silaswaxter/senior_design_buck_converter/requirements.md

# Requirements for Buck Converter

- Needs to be implemented via a custom PCB you designed
- Vin can be 8V-15V. Vout must be 5V nominal (±300mV) at 1.5A Inominal
- Main chip is TPS54232D/TPS54233D (start from figure 10, read about recommended
  layout in section 11.2)
  - We have a small supply of these chips if you can not find one
