silaswaxter/senior_design_buck_converter/recitation_buck_converter.kicad_pcb

## KiCad design recitation_buck_converter.kicad_pcb (2023-11-02)

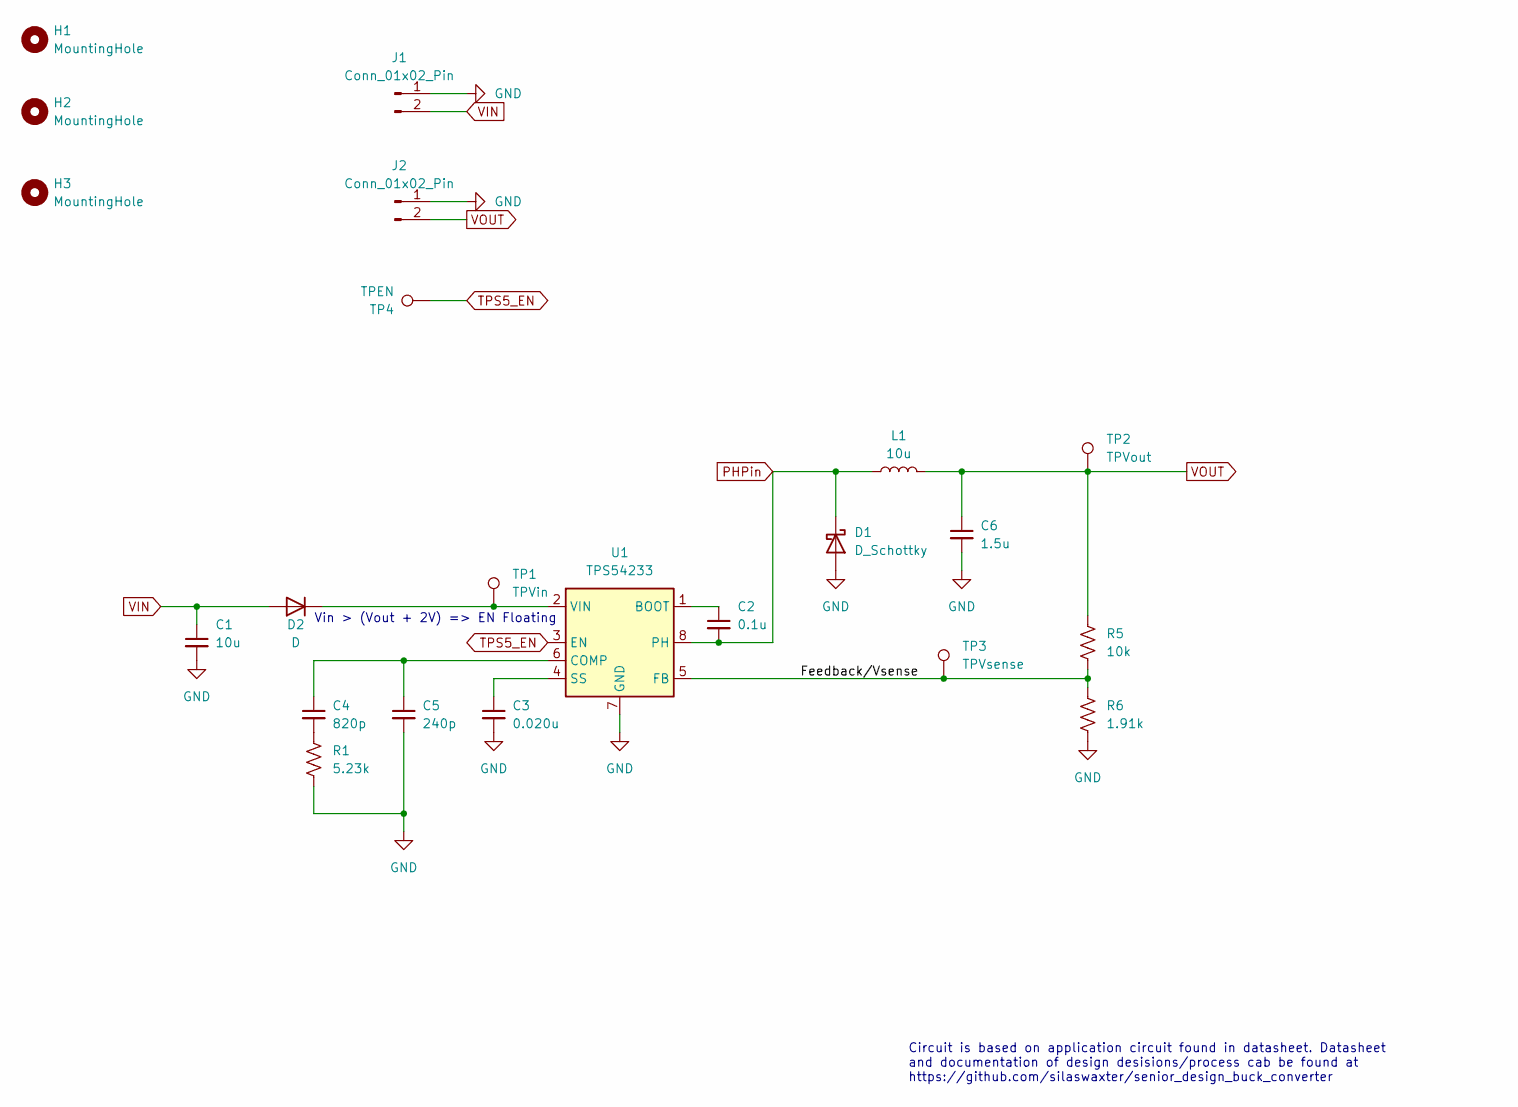
[picture p1: schematic recitation_buck_converter.kicad_sch, Buck Converter Sample]

Parts:
C1: 10u; C_0805_2012Metric_Pad1.18x1.45mm_HandSolder; Digikey PN 399-11939-2-ND
C2: 0.1u; C_0805_2012Metric_Pad1.18x1.45mm_HandSolder; Digikey PN 399-C0805C104M5RAC7800CT-ND
C3: 0.020u; C_0805_2012Metric_Pad1.18x1.45mm_HandSolder; Digikey PN 478-08055C203KAT2ATR-ND
C4: 820p; C_0805_2012Metric_Pad1.18x1.45mm_HandSolder; Digikey PN 311-3382-1-ND
C5: 240p; C_0805_2012Metric_Pad1.18x1.45mm_HandSolder; Digikey PN 311-4232-1-ND
C6: 1.5u; C_0805_2012Metric_Pad1.18x1.45mm_HandSolder; Digikey PN 732-7655-2-ND
D1: D_Schottky; US2H; Digikey PN CUHS20F30H3FTR-ND
D2: D; D_SMA; Digikey PN 2616-SK26A-ND
H1, H2, H3: MountingHole; MountingHole_2.2mm_M2; Digikey PN DNP
J1, J2: Conn_01x02_Pin; JST_XH_B2B-XH-AM_1x02_P2.50mm_Vertical; Digikey PN DNP
L1: 10u; L_Axial_L9.5mm_D4.0mm_P5.08mm_Vertical_Fastron_SMCC; Digikey PN 495-6962-1-ND
R1: 5.23k; R_0805_2012Metric_Pad1.20x1.40mm_HandSolder; Digikey PN 311-5.23KCRCT-ND
R5: 10k; R_0805_2012Metric; Digikey PN RMCF0805FT10K0TR-ND
R6: 1.91k; R_0805_2012Metric_Pad1.20x1.40mm_HandSolder; Digikey PN 311-1.91KCRTR-ND
TP1: TPVin; TestPoint_Pad_1.5x1.5mm
TP2: TPVout; TestPoint_Pad_1.5x1.5mm
TP3: TPVsense; TestPoint_Pad_1.5x1.5mm
TP4: TPEN; TestPoint_Pad_1.5x1.5mm
U1: TPS54233; SOIC-8_3.9x4.9mm_P1.27mm; Digikey PN 296-23902-1-ND

Connections:
/Feedback/Vsense: R5.2, R6.1, TP3.1, U1.5 (FB)
GND: C1.2, C3.2, C5.2, C6.2, D1.2 (A), J1.1, J2.1, R1.2, R6.2, U1.7 (GND)
unnamed: C4.2, R1.1
unnamed: D2.1 (K), TP1.1, U1.2 (VIN)
unnamed: C2.1, U1.1 (BOOT)
unnamed: C4.1, C5.1, U1.6 (COMP)
unnamed: C3.1, U1.4 (SS)
PHPin: C2.2, D1.1 (K), L1.1, U1.8 (PH)
TPS5_EN: TP4.1, U1.3 (EN)
VIN: C1.1, D2.2 (A), J1.2
VOUT: C6.1, J2.2, L1.2, R5.1, TP2.1

Notes on the sheet:
Vin > (Vout + 2V) => EN Floating
Circuit is based on application circuit found in datasheet. Datasheet and documentation of design desisions/process cab be found at https://github.com/silaswaxter/senior_design_buck_converter

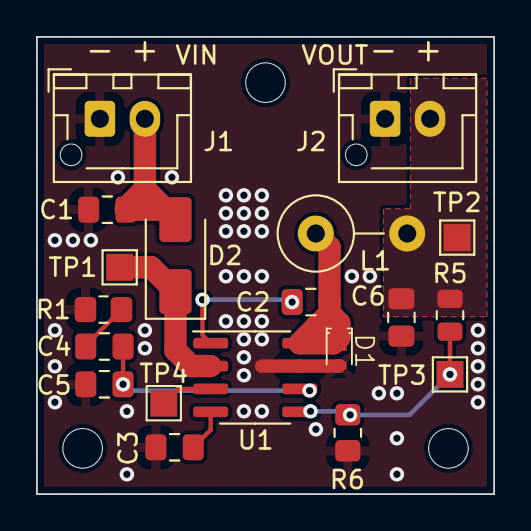
[picture p2: board recitation_buck_converter.kicad_pcb from above]

Board: 2 copper layers, 25.4 x 25.4 mm, 22 parts (0 on the bottom side), 11 nets.
