silaswaxter/senior_design_buck_converter/(commit log)

2023-10-05 chore: add kicad git ignore
2023-10-05 chore(datasheets): add datasheet for TI buck converter chip
2023-10-05 feat(schematic): minimal work for recitation 1 checkoff
    [recitation_buck_converter.kicad_pcb, recitation_buck_converter.kicad_sch]
2023-10-13 feat: update components to match specs and start layout
    [recitation_buck_converter.kicad_pcb, recitation_buck_converter.kicad_sch]
2023-10-13 docs(design): describe process for selecting vout resistors and inductor
2023-10-25 feat: add output components, float EN, and layouu with good track width
    [recitation_buck_converter.kicad_pcb, recitation_buck_converter.kicad_sch]
2023-11-02 feat: add compensation network; finish pcb
    [recitation_buck_converter.kicad_pcb, recitation_buck_converter.kicad_sch]
2023-11-02 fix(pcb): move dimensions to drawing layer
    [recitation_buck_converter.kicad_pcb, recitation_buck_converter.kicad_sch]
2023-11-02 feat: add vias for front-back ground fill
    [recitation_buck_converter.kicad_pcb]
2023-11-02 chore(gitignore): don't track gerbers or week 5 submission
